thoralt/esp8266wordclock/ledfunctions.cpp

// ESP8266 Wordclock
// Copyright (C) 2016 Thoralt Franz, https://github.com/thoralt
//
//  This module implements functions to manage the WS2812B LEDs. Two buffers contain
//  color information with current state and fade target state and are updated by
//  either simple set operations or integrated screensavers (matrix, stars, heart).
//  Also contains part of the data and logic for the hourglass animation.
//
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
// You should have received a copy of the GNU General Public License
// along with this program.  If not, see <http://www.gnu.org/licenses/>.
#include "ledfunctions.h"

//---------------------------------------------------------------------------------------
#if 1 // variables
//---------------------------------------------------------------------------------------

//---------------------------------------------------------------------------------------
// global instance
//---------------------------------------------------------------------------------------
LEDFunctionsClass LED = LEDFunctionsClass();

uint8_t fireBuf[NUM_PIXELS];
uint8_t plasmaBuf[NUM_PIXELS];

//---------------------------------------------------------------------------------------
// variables in PROGMEM (mapping table, images)
//---------------------------------------------------------------------------------------
#include "hourglass_animation.h"

// This defines the LED output for different minutes
// param0 controls whether the hour has to be incremented for the given minutes
// param1 is the matching minimum minute count (inclusive)
// param2 is the matching maximum minute count (inclusive)
#if 1 // code folding minutes template
const std::vector<leds_template_t> LEDFunctionsClass::minutesTemplate =
{
	{0,  0,  4, {107, 108, 109}},                                  // UHR
	{0,  5,  9, {7, 8, 9, 10, 40, 41, 42, 43}},                    // F�NF NACH
	{0, 10, 14, {11, 12, 13, 14, 40, 41, 42, 43}},                 // ZEHN NACH
	{1, 15, 19, {26, 27, 28, 29, 30, 31, 32}},                     // VIERTEL
	{1, 20, 24, {11, 12, 13, 14, 18, 19, 20, 33, 34, 35, 36}},     // ZEHN VOR HALB
	{1, 25, 29, {7, 8, 9, 10, 18, 19, 20, 33, 34, 35, 36}},        // F�NF VOR HALB
	{1, 30, 34, {33, 34, 35, 36}},                                 // HALB
	{1, 35, 39, {7, 8, 9, 10, 40, 41, 42, 43, 33, 34, 35, 36}},    // F�NF NACH HALB
	{1, 35, 39, {7, 8, 9, 10, 40, 41, 42, 43, 33, 34, 35, 36}},    // F�NF NACH HALB
/*	{1, 35, 39, {11, 12, 13, 14, 18, 19, 20, 22, 23, 24, 25, 26, 27, 28, 29, 30, 31, 32 }}, // ZEHN VOR DREIVIERTEL */
	{1, 40, 44, {11, 12, 13, 14, 40, 41, 42, 43, 33, 34, 35, 36}}, // ZEHN NACH HALB
/*	{1, 40, 44, {7, 8, 9, 10, 18, 19, 20, 22, 23, 24, 25, 26, 27, 28, 29, 30, 31, 32 }}, // F�NF VOR DREIVIERTEL */
	{1, 45, 49, {22, 23, 24, 25, 26, 27, 28, 29, 30, 31, 32 }},    // DREIVIERTEL
	{1, 50, 54, {11, 12, 13, 14, 18, 19, 20}},                     // ZEHN VOR
	{1, 55, 59, {7, 8, 9, 10, 18, 19, 20}}                         // F�NF VOR
};
#endif

// This defines the LED output for different hours
// param0 deals with special cases:
//     = 0: matches hour in param1 and param2
//     = 1: matches hour in param1 and param2 whenever minute is < 5
//     = 2: matches hour in param1 and param2 whenever minute is >= 5
// param1: hour to match
// param2: alternative hour to match
#if 1 // code folding hours template
const std::vector<leds_template_t> LEDFunctionsClass::hoursTemplate =
{
	{0,  0, 12, {99, 100, 101, 102, 103}}, // ZW�LF
	{1,  1, 13, {44, 45, 46}},             // EIN
	{2,  1, 13, {44, 45, 46, 47}},         // EINS
	{0,  2, 14, {51, 52, 53, 54}},         // ZWEI
	{0,  3, 15, {55, 56, 57, 58}},         // DREI
	{0,  4, 16, {62, 63, 64, 65}},         // VIER
	{0,  5, 17, {66, 67, 68, 69}},         // F�NF
	{0,  6, 18, {72, 73, 74, 75, 76}},     // SECHS
	{0,  7, 19, {77, 78, 79, 80, 81, 82}}, // SIEBEN
	{0,  8, 20, {84, 85, 86, 87}},         // ACHT
	{0,  9, 21, {88, 89, 90, 91}},         // NEUN
	{0, 10, 22, {92, 93, 94, 95}},         // ZEHN
	{0, 11, 23, {96, 97, 98}},             // ELF
};
#endif

#if 1 // code folding mapping table
// this mapping table maps the linear memory buffer structure used throughout the
// project to the physical layout of the LEDs
const uint32_t PROGMEM LEDFunctionsClass::mapping[NUM_PIXELS] = {
	10,   9,   8,   7,   6,   5,   4,   3,   2,   1,   0,
	11,  12,  13,  14,  15,  16,  17,  18,  19,  20,  21,
	32,  31,  30,  29,  28,  27,  26,  25,  24,  23,  22,
	33,  34,  35,  36,  37,  38,  39,  40,  41,  42,  43,
	54,  53,  52,  51,  50,  49,  48,  47,  46,  45,  44,
	55,  56,  57,  58,  59,  60,  61,  62,  63,  64,  65,
	76,  75,  74,  73,  72,  71,  70,  69,  68,  67,  66,
	77,  78,  79,  80,  81,  82,  83,  84,  85,  86,  87,
	98,  97,  96,  95,  94,  93,  92,  91,  90,  89,  88,
	99, 100, 101, 102, 103, 104, 105, 106, 107, 108, 109,
	112, 111, 110, 113
};
#endif

#if 1 // code folding brightness adjust tables
const uint32_t PROGMEM LEDFunctionsClass::brightnessCurveSelect[NUM_PIXELS] = {
				0, 0, 0, 0, 0, 0, 0, 0, 0, 0, 0,
				0, 0, 0, 0, 0, 0, 0, 0, 0, 0, 0,
				0, 0, 0, 0, 0, 0, 0, 0, 0, 0, 0,
				0, 0, 0, 0, 0, 0, 0, 0, 0, 0, 0,
				0, 0, 0, 0, 0, 0, 0, 0, 0, 0, 0,
				0, 0, 0, 0, 0, 0, 0, 0, 0, 0, 0,
				0, 0, 0, 0, 0, 0, 0, 0, 0, 0, 0,
				0, 0, 0, 0, 0, 0, 0, 0, 0, 0, 0,
				0, 0, 0, 0, 0, 0, 0, 0, 0, 0, 0,
				0, 0, 0, 0, 0, 0, 0, 0, 0, 0, 0,
				0, 0, 0, 0
		//		0, 0, 0, 0, 0, 0, 0, 0, 0, 0, 0,
		//		0, 0, 0, 0, 0, 0, 0, 0, 0, 0, 0,
		//		0, 0, 0, 0, 0, 0, 0, 0, 0, 0, 0,
		//		0, 0, 0, 0, 0, 0, 0, 0, 0, 0, 0,
		//		0, 0, 0, 0, 0, 0, 0, 0, 0, 0, 0,
		//		0, 0, 0, 0, 0, 0, 0, 0, 0, 0, 0,
		//		0, 0, 0, 0, 0, 0, 0, 0, 0, 0, 0,
		//		0, 0, 0, 0, 0, 0, 0, 0, 0, 0, 0,
		//		0, 0, 0, 1, 0, 0, 0, 0, 0, 0, 0,
		//		0, 0, 0, 0, 0, 0, 0, 0, 0, 0, 0,
		//		0, 0, 0, 0
		//		0, 0, 0, 0, 0, 0, 1, 0, 0, 0, 0,
		//		1, 0, 0, 0, 0, 0, 0, 0, 0, 0, 0,
		//		0, 0, 0, 0, 0, 0, 0, 0, 0, 0, 0,
		//		0, 0, 0, 0, 0, 0, 0, 0, 0, 0, 0,
		//		0, 0, 0, 0, 0, 0, 0, 0, 0, 0, 0,
		//		0, 0, 0, 0, 0, 0, 0, 0, 0, 0, 0,
		//		0, 0, 0, 0, 0, 0, 0, 0, 0, 0, 0,
		//		0, 1, 1, 1, 1, 1, 1, 1, 1, 1, 1,
		//		1, 1, 1, 1, 1, 1, 1, 1, 1, 1, 0,
		//		0, 1, 1, 1, 1, 1, 1, 1, 1, 0, 1,
		//		0, 1, 0, 1
};

const uint32_t PROGMEM LEDFunctionsClass::brightnessCurvesR[256*NUM_BRIGHTNESS_CURVES] = {
		// LED type 1, 1:1 mapping (neutral)
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
		208, 209, 210, 211, 212, 213, 214, 215, 216, 217, 218, 219, 220,
		221, 222, 223, 224, 225, 226, 227, 228, 229, 230, 231, 232, 233,
		234, 235, 236, 237, 238, 239, 240, 241, 242, 243, 244, 245, 246,
		247, 248, 249, 250, 251, 252, 253, 254, 255,

		// LED type 2
		0, 0, 0, 0, 0, 0, 0, 0, 0, 0, 3, 3, 5, 5, 5, 5, 5, 5, 7, 7, 7, 7, 9,
		9, 9, 9, 9, 9, 11, 11, 11, 11, 13, 13, 13, 13, 15, 15, 15, 15, 17,
		17, 19, 19, 20, 20, 21, 21, 23, 23, 25, 25, 27, 27, 29, 29, 31, 31,
		33, 33, 35, 35, 37, 37, 39, 39, 41, 41, 42, 42, 43, 43, 45, 45, 47,
		47, 49, 49, 51, 51, 53, 53, 55, 55, 57, 57, 59, 59, 61, 61, 63, 63,
		64, 64, 66, 66, 68, 68, 72, 72, 72, 72, 74, 74, 76, 76, 78, 78, 80,
		80, 82, 82, 84, 84, 86, 86, 88, 88, 90, 90, 91, 91, 93, 93, 94, 94,
		96, 96, 98, 98, 100, 100, 102, 102, 104, 104, 106, 106, 108, 108,
		110, 110, 112, 112, 114, 114, 116, 116, 118, 118, 119, 119, 121, 121,
		123, 123, 124, 124, 127, 127, 129, 129, 131, 131, 133, 133, 135, 137,
		137, 139, 139, 141, 141, 143, 143, 145, 145, 147, 147, 149, 149, 151,
		151, 153, 153, 155, 155, 157, 157, 160, 160, 161, 161, 163, 163, 166,
		166, 168, 168, 170, 170, 171, 171, 174, 174, 176, 176, 178, 178, 180,
		180, 183, 183, 184, 184, 187, 187, 188, 188, 191, 191, 194, 194, 196,
		196, 198, 198, 200, 200, 202, 202, 204, 204, 206, 206, 209, 209, 210,
		210, 212, 212, 215, 215, 217, 217, 219, 219, 222, 222, 224, 224, 226,
		226, 228, 228, 230
};

#endif

#endif

//---------------------------------------------------------------------------------------
#if 1 // getters, setters, data flow
//---------------------------------------------------------------------------------------

//---------------------------------------------------------------------------------------
// ~LEDFunctionsClass
//
// Destructor
//
// -> --
// <- --
//---------------------------------------------------------------------------------------
LEDFunctionsClass::~LEDFunctionsClass()
{
//	for(MatrixObject* m : this->matrix_objects) delete m;
}

//---------------------------------------------------------------------------------------
// LEDFunctionsClass
//
// Constructor, initializes data structures
//
// -> --
// <- --
//---------------------------------------------------------------------------------------
LEDFunctionsClass::LEDFunctionsClass()
{
	// initialize matrix objects with random coordinates
	for (int i = 0; i < NUM_MATRIX_OBJECTS; i++)
	{
		this->matrix.push_back(MatrixObject());
	}

	// initialize star objects with default coordinates
	for (int i = 0; i < NUM_STARS; i++) this->stars.push_back(StarObject());

	// set random coordinates with minimum distance to other star objects
	for (StarObject& s : this->stars) s.randomize(this->stars);
}

//---------------------------------------------------------------------------------------
// begin
//
// Initializes the LED driver
//
// -> pin: hardware pin to use for WS2812B data output
// <- --
//---------------------------------------------------------------------------------------
void LEDFunctionsClass::begin(int pin)
{
	this->pixels = new Adafruit_NeoPixel(NUM_PIXELS, pin, NEO_GRB + NEO_KHZ800);
	this->pixels->begin();
}

//---------------------------------------------------------------------------------------
// process
//
// Drives internal data flow, should be called repeatedly from main loop()
//
// -> --
// <- --
//---------------------------------------------------------------------------------------
void LEDFunctionsClass::process()
{
	if(Config.debugMode) return;

	// check time values against boundaries
	if(this->h > 23 || this->h < 0) this->h = 0;
	if(this->m > 59 || this->m < 0) this->m = 0;
	if(this->s > 59 || this->s < 0) this->s = 0;
	if(this->ms > 999 || this->ms < 0) this->ms = 0;

	// load palette colors from configuration
	palette_entry palette[] = {
		{Config.bg.r, Config.bg.g, Config.bg.b},
		{Config.fg.r, Config.fg.g, Config.fg.b},
		{Config.s.r,  Config.s.g,  Config.s.b}};
	uint8_t buf[NUM_PIXELS];

	switch(this->mode)
	{
	case DisplayMode::wifiManager:
		this->renderWifiManager();
		break;
	case DisplayMode::yellowHourglass:
		this->renderHourglass(Config.hourglassState, false);
		break;
	case DisplayMode::greenHourglass:
		this->renderHourglass(Config.hourglassState, true);
		break;
	case DisplayMode::update:
		this->renderUpdate();
		break;
	case DisplayMode::updateComplete:
		this->renderUpdateComplete();
		break;
	case DisplayMode::updateError:
		this->renderUpdateError();
		break;
	case DisplayMode::red:
		this->renderRed();
		break;
	case DisplayMode::green:
		this->renderGreen();
		break;
	case DisplayMode::blue:
		this->renderBlue();
		break;
	case DisplayMode::flyingLettersVerticalUp:
	case DisplayMode::flyingLettersVerticalDown:
		this->renderFlyingLetters();
		break;
	case DisplayMode::explode:
		this->renderExplosion();
		break;
	case DisplayMode::matrix:
		this->renderMatrix();
		break;
	case DisplayMode::heart:
		this->renderHeart();
		break;
	case DisplayMode::stars:
		this->renderStars();
		break;
	case DisplayMode::fire:
		this->renderFire();
		break;
	case DisplayMode::plasma:
		this->renderPlasma();
		break;
	case DisplayMode::fade:
		this->renderTime(buf, this->h, this->m, this->s, this->ms);
		this->set(buf, palette, false);
		this->fade();
		break;

	case DisplayMode::random: // TODO: Implement random display mode
	case DisplayMode::plain:
	default:
		this->renderTime(buf, this->h, this->m, this->s, this->ms);
		this->set(buf, palette, true);
		break;
	}


	// transfer this->currentValues to LEDs
	this->show();
}

//---------------------------------------------------------------------------------------
// setBrightness
//
// Sets the brightness for the WS2812 values. Will be multiplied with each color
// component when sending data to WS2812.
//
// -> brightness: [0...256]
// <- --
//---------------------------------------------------------------------------------------
void LEDFunctionsClass::setBrightness(int brightness)
{
	this->brightness = brightness;
}

//---------------------------------------------------------------------------------------
// setTime
//
// Sets the time which will be used to drive the LED matrix. The internal time is _not_
// updated, this function must be called repeatedly if the time changes.
//
// -> h, m, s, ms: Time in hours, minutes, seconds, milliseconds
// <- --
//---------------------------------------------------------------------------------------
void LEDFunctionsClass::setTime(int h, int m, int s, int ms)
{
	this->h = h;
	this->m = m;
	this->s = s;
	this->ms = ms;
}

//---------------------------------------------------------------------------------------
// setMode
//
// Sets the display mode to one of the members of the DisplayMode enum and thus changes
// what will be shown on the display during the next calls of LEDFunctionsClass.process()
//
// -> newMode: mode to be set
// <- --
//---------------------------------------------------------------------------------------
void LEDFunctionsClass::setMode(DisplayMode newMode)
{
	uint8_t buf[NUM_PIXELS];
	DisplayMode previousMode = this->mode;
	this->mode = newMode;

	// if we changed to an animated letters mode, then start animation
	// even if the current time did not yet change
	if(newMode != previousMode &&
			(newMode == DisplayMode::flyingLettersVerticalUp ||
			newMode == DisplayMode::flyingLettersVerticalDown))
	{
		this->renderTime(buf, this->h, this->m, this->s, this->ms);
		this->prepareFlyingLetters(buf);
	}

	// if we changed to exploding letters mode, then start animation
	// even if the current time did not yet change
	if(newMode != previousMode && newMode == DisplayMode::explode)
	{
		this->renderTime(buf, this->h, this->m, this->s, this->ms);
		this->prepareExplosion(buf);
	}

	this->process();
}

//---------------------------------------------------------------------------------------
// set
//
// Sets the internal LED buffer to new values based on an indexed source buffer and an
// associated palette. Does not display colors immediately, fades to new colors instead.
//
// Attention: If buf is PROGMEM, make sure it is aligned at 32 bit and its size is
// a multiple of 4 bytes!
//
// -> buf: indexed source buffer
//	palette: color definition for source buffer
// <- --
//---------------------------------------------------------------------------------------
void LEDFunctionsClass::set(const uint8_t *buf, palette_entry palette[])
{
	this->set(buf, palette, false);
}

//---------------------------------------------------------------------------------------
// set
//
// Sets the internal LED buffer to new values based on an indexed source buffer and an
// associated palette.
//
// Attention: If buf is PROGMEM, make sure it is aligned at 32 bit and its size is
// a multiple of 4 bytes!
//
// -> buf: indexed source buffer
//	  palette: color definition for source buffer
//	  immediately: if true, display buffer immediately; fade to new colors if false
// <- --
//---------------------------------------------------------------------------------------
void LEDFunctionsClass::set(const uint8_t *buf, palette_entry palette[],
		bool immediately)
{
	this->setBuffer(this->targetValues, buf, palette);

	if (immediately)
	{
		this->setBuffer(this->currentValues, buf, palette);
	}
}

//---------------------------------------------------------------------------------------
// setBuffer
//
// Fills a buffer (e. g. this->targetValues) with color data based on indexed source
// pixels and a palette. Pays attention to 32 bit boundaries, so use with PROGMEM is
// safe.
//
// -> target: color buffer, e. g. this->targetValues or this->currentValues
//    source: buffer with color indexes
//	  palette: colors for indexed source buffer
// <- --
//---------------------------------------------------------------------------------------
void LEDFunctionsClass::setBuffer(uint8_t *target, const uint8_t *source,
		palette_entry palette[])
{
	uint32_t mapping, palette_index, curveOffset;

	// cast source to 32 bit pointer to ensure 32 bit aligned access
	uint32_t *buf = (uint32_t*) source;
	// this holds the current 4 bytes
	uint32_t currentDWord;
	// this is a pointer to the current 4 bytes for access as single bytes
	uint8_t *currentBytes = (uint8_t*) &currentDWord;
	// this counts bytes from 0...3
	uint32_t byteCounter = 0;
	for (int i = 0; i < NUM_PIXELS; i++)
	{
		// get next 4 bytes
		if (byteCounter == 0) currentDWord = buf[i >> 2];

		palette_index = currentBytes[byteCounter];
		mapping = LEDFunctionsClass::mapping[i] * 3;
		curveOffset = LEDFunctionsClass::brightnessCurveSelect[i] << 8;

		// select color value using palette and brightness correction curves
		target[mapping + 0] = brightnessCurvesR[curveOffset + palette[palette_index].r];
		target[mapping + 1] = brightnessCurvesG[curveOffset + palette[palette_index].g];
		target[mapping + 2] = brightnessCurvesB[curveOffset + palette[palette_index].b];

		byteCounter = (byteCounter + 1) & 0x03;
	}
}

//---------------------------------------------------------------------------------------
// fade
//
// Fade one step of the color values from this->currentValues[i] to 
// this->targetValues[i]. Uses non-linear fade speed depending on distance to target
// value.
//
// -> --
// <- --
//---------------------------------------------------------------------------------------
void LEDFunctionsClass::fade()
{
	static int prescaler = 0;
	if(++prescaler<2) return;
	prescaler = 0;

	int delta;
	for (int i = 0; i < NUM_PIXELS * 3; i++)
	{
		delta = this->targetValues[i] - this->currentValues[i];
		if (delta > 64) this->currentValues[i] += 8;
		else if (delta > 16) this->currentValues[i] += 4;
		else if (delta > 0) this->currentValues[i]++;
		else if (delta < -64) this->currentValues[i] -= 8;
		else if (delta < -16) this->currentValues[i] -= 4;
		else if (delta < 0) this->currentValues[i]--;
	}
}

//---------------------------------------------------------------------------------------
// show
//
// Internal method, copies this->currentValues to WS2812 object while applying brightness
//
// -> --
// <- --
//---------------------------------------------------------------------------------------
void LEDFunctionsClass::show()
{
	uint8_t *data = this->currentValues;
	int ofs = 0;

	// copy current color values to LED object and display it
	for (int i = 0; i < NUM_PIXELS; i++)
	{
		this->pixels->setPixelColor(i,
				pixels->Color(((int) data[ofs + 0] * this->brightness) >> 8,
						      ((int) data[ofs + 1] * this->brightness) >> 8,
						      ((int) data[ofs + 2] * this->brightness) >> 8));
		ofs += 3;
	}
	this->pixels->show();
}

//---------------------------------------------------------------------------------------
// getOffset
//
// Calculates the offset of a given RGB triplet inside the LED buffer.
// Does range checking for x and y, uses the internal mapping table.
//
// -> x: x coordinate
//    y: y coordinate
// <- offset for given coordinates
//---------------------------------------------------------------------------------------
int LEDFunctionsClass::getOffset(int x, int y)
{
	if (x>=0 && y>=0 && x<LEDFunctionsClass::width && y<LEDFunctionsClass::height)
	{
		return LEDFunctionsClass::mapping[x + y*LEDFunctionsClass::width] * 3;
	}
	else
	{
		return 0;
	}
}

//---------------------------------------------------------------------------------------
// fillBackground
//
// Initializes the buffer with either background (=0) or seconds progress (=2),
// part of the background will be illuminated with color 2 depending on current
// seconds/milliseconds value, whole screen is backlit when seconds = 59
//
// -> seconds, milliseconds: Time value which the fill process will base on
//    buf: destination buffer
// <- --
//---------------------------------------------------------------------------------------
void LEDFunctionsClass::fillBackground(int seconds, int milliseconds, uint8_t *buf)
{
	int pos = (((seconds * 1000 + milliseconds) * 110) / 60000) + 1;
	for (int i = 0; i < NUM_PIXELS; i++) buf[i] = (i < pos) ? 2 : 0;
}

#endif

//---------------------------------------------------------------------------------------
#if 1 // rendering methods
//---------------------------------------------------------------------------------------

//---------------------------------------------------------------------------------------
// renderTime
//
// Loads internal buffers with the current time representation
//
// -> target: If NULL, a local buffer is used and time is actually being displayed
//            if not null, time is not being displayed, but the given buffer is being
//            filled with palette indexes representing the time
// <- --
//---------------------------------------------------------------------------------------
void LEDFunctionsClass::renderTime(uint8_t *target, int h, int m, int s, int ms)
{
	this->fillBackground(s, ms, target);

	// set static LEDs
	target[0] = 1; // E
	target[1] = 1; // S

	target[3] = 1; // I
	target[4] = 1; // S
	target[5] = 1; // T

	// minutes 1...4 for the corners
	for(int i=0; i<=((m%5)-1); i++) target[10 * 11 + i] = 1;

	// iterate over minutes_template
	int adjust_hour = 0;
	for(leds_template_t t : LEDFunctionsClass::minutesTemplate)
	{
		// test if this template matches the current minute
		if(m >= t.param1 && m <= t.param2)
		{
			// set all LEDs defined in this template
			for(int i : t.LEDs) target[i] = 1;
			adjust_hour = t.param0;
			break;
		}
	}

	// adjust hour display if necessary (e. g. 09:45 = quarter to *TEN* instead of NINE)
	h += adjust_hour;
	if(h > 23)	h -= 24;

	// iterate over hours template
	for(leds_template_t t : LEDFunctionsClass::hoursTemplate)
	{
		// test if this template matches the current hour
		if((t.param1 == h || t.param2 == h) &&
		   ((t.param0 == 1 && m < 5)  || // special case full hour
			(t.param0 == 2 && m >= 5) || // special case hour + minutes
			(t.param0 == 0)))            // normal case
		{
			// set all LEDs defined in this template
			for(int i : t.LEDs) target[i] = 1;
			break;
		}
	}

	// DEBUG
	static int last_minutes = -1;
	if(last_minutes != this->m)
	{
		last_minutes = this->m;
		Serial.printf("h=%i, m=%i, s=%i\r\n", this->h, this->m, this->s);
		for(int y=0; y<10; y++)
		{
			for(int x=0; x<11; x++)
			{
				Serial.print(target[y*11+x]);
				Serial.print(' ');
			}
			Serial.println(' ');
		}
	}
}

//---------------------------------------------------------------------------------------
// renderHourglass
//
// Immediately displays an animation step of the hourglass animation.
// ATTENTION: Animation frames must start at 32 bit boundary each!
//
// -> animationStep: Number of current frame [0...HOURGLASS_ANIMATION_FRAMES]
//    green: Flag to switch the palette color 3 to green instead of yellow (used in the
//           second half of the hourglass animation to indicate the short wait-for-OTA
//           window)
// <- --
//---------------------------------------------------------------------------------------
void LEDFunctionsClass::renderHourglass(uint8_t animationStep, bool green)
{
	// colors in palette: black, white, yellow
	palette_entry p[] = {{0, 0, 0}, {255, 255, 255}, {255, 255, 0}, {255, 255, 0}};

	// delete red component in palette entry 3 to make this color green
	if(green) p[3].r = 0;

	if (animationStep >= HOURGLASS_ANIMATION_FRAMES) animationStep = 0;
	this->set(hourglass_animation[animationStep], p, true);
}

//---------------------------------------------------------------------------------------
// renderMatrix
//
// Renders one frame of the matrix animation and displays it immediately
//
// -> --
// <- --
//---------------------------------------------------------------------------------------
void LEDFunctionsClass::renderMatrix()
{
	// clear buffer
	memset(this->currentValues, 0, sizeof(this->currentValues));

	// sort by y coordinate for correct overlapping
	std::sort(matrix.begin(), matrix.end());

	// iterate over all matrix objects, move and render them
	for (MatrixObject &m : this->matrix) m.render(this->currentValues);
}

const palette_entry LEDFunctionsClass::firePalette[256] = {
	{0, 0, 0}, {4, 0, 0}, {8, 0, 0}, {12, 0, 0}, {16, 0, 0}, {20, 0, 0}, {24, 0, 0}, {28, 0, 0},
	{32, 0, 0}, {36, 0, 0}, {40, 0, 0}, {44, 0, 0}, {48, 0, 0}, {52, 0, 0}, {56, 0, 0}, {60, 0, 0},
	{64, 0, 0}, {68, 0, 0}, {72, 0, 0}, {76, 0, 0}, {80, 0, 0}, {85, 0, 0}, {89, 0, 0}, {93, 0, 0},
	{97, 0, 0}, {101, 0, 0}, {105, 0, 0}, {109, 0, 0}, {113, 0, 0}, {117, 0, 0}, {121, 0, 0}, {125, 0, 0},
	{129, 0, 0}, {133, 0, 0}, {137, 0, 0}, {141, 0, 0}, {145, 0, 0}, {149, 0, 0}, {153, 0, 0}, {157, 0, 0},
	{161, 0, 0}, {165, 0, 0}, {170, 0, 0}, {174, 0, 0}, {178, 0, 0}, {182, 0, 0}, {186, 0, 0}, {190, 0, 0},
	{194, 0, 0}, {198, 0, 0}, {202, 0, 0}, {206, 0, 0}, {210, 0, 0}, {214, 0, 0}, {218, 0, 0}, {222, 0, 0},
	{226, 0, 0}, {230, 0, 0}, {234, 0, 0}, {238, 0, 0}, {242, 0, 0}, {246, 0, 0}, {250, 0, 0}, {255, 0, 0},
	{255, 0, 0}, {255, 8, 0}, {255, 16, 0}, {255, 24, 0}, {255, 32, 0}, {255, 41, 0}, {255, 49, 0}, {255, 57, 0},
	{255, 65, 0}, {255, 74, 0}, {255, 82, 0}, {255, 90, 0}, {255, 98, 0}, {255, 106, 0}, {255, 115, 0}, {255, 123, 0},
	{255, 131, 0}, {255, 139, 0}, {255, 148, 0}, {255, 156, 0}, {255, 164, 0}, {255, 172, 0}, {255, 180, 0}, {255, 189, 0},
	{255, 197, 0}, {255, 205, 0}, {255, 213, 0}, {255, 222, 0}, {255, 230, 0}, {255, 238, 0}, {255, 246, 0}, {255, 255, 0},
	{255, 255, 0}, {255, 255, 1}, {255, 255, 3}, {255, 255, 4}, {255, 255, 6}, {255, 255, 8}, {255, 255, 9}, {255, 255, 11},
	{255, 255, 12}, {255, 255, 14}, {255, 255, 16}, {255, 255, 17}, {255, 255, 19}, {255, 255, 20}, {255, 255, 22}, {255, 255, 24},
	{255, 255, 25}, {255, 255, 27}, {255, 255, 28}, {255, 255, 30}, {255, 255, 32}, {255, 255, 33}, {255, 255, 35}, {255, 255, 36},
	{255, 255, 38}, {255, 255, 40}, {255, 255, 41}, {255, 255, 43}, {255, 255, 44}, {255, 255, 46}, {255, 255, 48}, {255, 255, 49},
	{255, 255, 51}, {255, 255, 52}, {255, 255, 54}, {255, 255, 56}, {255, 255, 57}, {255, 255, 59}, {255, 255, 60}, {255, 255, 62},
	{255, 255, 64}, {255, 255, 65}, {255, 255, 67}, {255, 255, 68}, {255, 255, 70}, {255, 255, 72}, {255, 255, 73}, {255, 255, 75},
	{255, 255, 76}, {255, 255, 78}, {255, 255, 80}, {255, 255, 81}, {255, 255, 83}, {255, 255, 85}, {255, 255, 86}, {255, 255, 88},
	{255, 255, 89}, {255, 255, 91}, {255, 255, 93}, {255, 255, 94}, {255, 255, 96}, {255, 255, 97}, {255, 255, 99}, {255, 255, 101},
	{255, 255, 102}, {255, 255, 104}, {255, 255, 105}, {255, 255, 107}, {255, 255, 109}, {255, 255, 110}, {255, 255, 112}, {255, 255, 113},
	{255, 255, 115}, {255, 255, 117}, {255, 255, 118}, {255, 255, 120}, {255, 255, 121}, {255, 255, 123}, {255, 255, 125}, {255, 255, 126},
	{255, 255, 128}, {255, 255, 129}, {255, 255, 131}, {255, 255, 133}, {255, 255, 134}, {255, 255, 136}, {255, 255, 137}, {255, 255, 139},
	{255, 255, 141}, {255, 255, 142}, {255, 255, 144}, {255, 255, 145}, {255, 255, 147}, {255, 255, 149}, {255, 255, 150}, {255, 255, 152},
	{255, 255, 153}, {255, 255, 155}, {255, 255, 157}, {255, 255, 158}, {255, 255, 160}, {255, 255, 161}, {255, 255, 163}, {255, 255, 165},
	{255, 255, 166}, {255, 255, 168}, {255, 255, 170}, {255, 255, 171}, {255, 255, 173}, {255, 255, 174}, {255, 255, 176}, {255, 255, 178},
	{255, 255, 179}, {255, 255, 181}, {255, 255, 182}, {255, 255, 184}, {255, 255, 186}, {255, 255, 187}, {255, 255, 189}, {255, 255, 190},
	{255, 255, 192}, {255, 255, 194}, {255, 255, 195}, {255, 255, 197}, {255, 255, 198}, {255, 255, 200}, {255, 255, 202}, {255, 255, 203},
	{255, 255, 205}, {255, 255, 206}, {255, 255, 208}, {255, 255, 210}, {255, 255, 211}, {255, 255, 213}, {255, 255, 214}, {255, 255, 216},
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
	{255, 0, 48}, {255, 0, 42}, {255, 0, 36}, {255, 0, 30}, {255, 0, 24}, {255, 0, 18}, {255, 0, 12}, {255, 0, 6}
};


double _time = 0;
void LEDFunctionsClass::renderPlasma()
{
    int color;
    double cx, cy, xx, yy;

    _time += 0.05;

    for (int y=0; y<LEDFunctionsClass::height; y++)
    {
        yy = (double)y / (double)LEDFunctionsClass::height / 3.0;
        for (int x=0; x<LEDFunctionsClass::width; x++)
        {
            xx = (double)x / (double)LEDFunctionsClass::width / 3.0;
            cx = xx + 0.5 * sin(_time / 5.0);
            cy = (double)y/(double)LEDFunctionsClass::height / 3.0 + 0.5 * sin(_time / 3.0);
            color = (
            	sin(
                    sqrt(100 * (cx*cx + cy*cy) + 1 + _time) +
                    6.0 * (xx * sin(_time/2) + yy * cos(_time/3) + _time / 4.0)
                ) + 1.0
			) * 128.0;
            plasmaBuf[x + y * LEDFunctionsClass::width] = color;
        }
    }
    this->set(plasmaBuf, (palette_entry*)plasmaPalette, true);
}

void LEDFunctionsClass::renderFire()
{
    int f;

    // iterate over bottom row, create fire seed
    for (int i = 0; i < LEDFunctionsClass::width; i++)
    {
        // only set hot spot with probability of 1/4
        f = (random(4) == 0) ? random(256) : 0;

        // update one pixel in bottom row
        fireBuf[i + (LEDFunctionsClass::height - 1) * LEDFunctionsClass::width] = f;
    }

    int y1, y2, l, r;
    for (int y = 0; y < LEDFunctionsClass::height - 1; y++)
    {
        y1 = y + 1; if (y1 >= LEDFunctionsClass::height) y1 = LEDFunctionsClass::height - 1;
        y2 = y + 2; if (y2 >= LEDFunctionsClass::height) y2 = LEDFunctionsClass::height - 1;
        for (int x = 0; x < LEDFunctionsClass::width; x++)
        {
            l = x - 1; if (l < 0) l = 0;
            r = x + 1; if (r >= LEDFunctionsClass::width) r = LEDFunctionsClass::width - 1;
            fireBuf[x + y * LEDFunctionsClass::width] =
                ((fireBuf[y1 * LEDFunctionsClass::width + l]
                + fireBuf[y1 * LEDFunctionsClass::width + x]
                + fireBuf[y1 * LEDFunctionsClass::width + r]
                + fireBuf[y2 * LEDFunctionsClass::width + x])
                * 32) / 129;
        }
    }
    this->set(fireBuf, (palette_entry*)firePalette, true);
	delay(100);
}

//---------------------------------------------------------------------------------------
// renderStars
//
// Renders one frame of the stars animation and displays it immediately
//
// -> --
// <- --
//---------------------------------------------------------------------------------------
void LEDFunctionsClass::renderStars()
{
	// clear buffer
	memset(this->currentValues, 0, sizeof(this->currentValues));

	for(StarObject &s : this->stars) s.render(this->currentValues, this->stars);
}

//---------------------------------------------------------------------------------------
// renderHeart
//
// Renders one frame of the heart animation and displays it immediately
//
// -> --
// <- --
//---------------------------------------------------------------------------------------
void LEDFunctionsClass::renderHeart()
{
	palette_entry palette[2];
	uint8_t heart[] = {
		0, 1, 1, 1, 0, 0, 0, 1, 1, 1, 0,
		1, 1, 1, 1, 1, 0, 1, 1, 1, 1, 1,
		1, 1, 1, 1, 1, 1, 1, 1, 1, 1, 1,
		1, 1, 1, 1, 1, 1, 1, 1, 1, 1, 1,
		0, 1, 1, 1, 1, 1, 1, 1, 1, 1, 0,
		0, 0, 1, 1, 1, 1, 1, 1, 1, 0, 0,
		0, 0, 0, 1, 1, 1, 1, 1, 0, 0, 0,
		0, 0, 0, 0, 1, 1, 1, 0, 0, 0, 0,
		0, 0, 0, 0, 0, 1, 0, 0, 0, 0, 0,
		0, 0, 0, 0, 0, 0, 0, 0, 0, 0, 0,
		1, 1, 1, 1
	};
	palette[0] = {0, 0, 0};
	palette[1] = {(uint8_t)this->heartBrightness, 0, 0};
	this->set(heart, palette, true);

	switch (this->heartState)
	{
	case 0:
		if (this->heartBrightness >= 255) this->heartState = 1;
		else this->heartBrightness += 32;
		break;

	case 1:
		if (this->heartBrightness < 128) this->heartState = 2;
		else this->heartBrightness -= 32;
		break;

	case 2:
		if (this->heartBrightness >= 255) this->heartState = 3;
		else this->heartBrightness += 32;
		break;

	case 3:
	default:
		if (this->heartBrightness <= 0) this->heartState = 0;
		else this->heartBrightness -= 4;
		break;
	}

	if (this->heartBrightness > 255) this->heartBrightness = 255;
	if (this->heartBrightness < 0) this->heartBrightness = 0;
}

//---------------------------------------------------------------------------------------
// prepareExplosion
//
// Prepare particles based on current screen state
//
//
// -> source: buffer to read the currently active LEDs from
// <- --
//---------------------------------------------------------------------------------------
void LEDFunctionsClass::prepareExplosion(uint8_t *source)
{
#define PARTICLE_COUNT 16
#define PARTICLE_SPEED 0.15f

	float vx, vy, angle;
	int ofs = 0;
	Particle *p;
	int delay;

	// compute angle increment
	float angle_increment = 2.0f * 3.141592654f / (float)(PARTICLE_COUNT);

	// iterate over every position in the screen buffer
	for(int y=0; y<LEDFunctionsClass::height; y++)
	{
		for(int x=0; x<LEDFunctionsClass::width; x++)
		{
			// create entry in particles vector if current pixel is foreground
			if(source[ofs++] == 1)
			{
				// add a random delay of zero to approx. 3 seconds to each
				// explosion
				delay = random(300);

				// start with angle of zero radians, assign velocity vector
				// placed on a circle to each particle
				angle = 0;
				for(int i=0; i<PARTICLE_COUNT; i++)
				{
					// calculate particle speed vector based on angle and
					// absolute speed value
					vx = PARTICLE_SPEED * sin(angle);
					vy = PARTICLE_SPEED * cos(angle);

					// create new particle and add it to particles list
					p = new Particle(x, y, vx, vy, delay);
					this->particles.push_back(p);
					angle += angle_increment;
				}
			}
		}
	}
}

//---------------------------------------------------------------------------------------
// renderExplosion
//
// Renders the exploding letters animation
//
// -> --
// <- --
//---------------------------------------------------------------------------------------
void LEDFunctionsClass::renderExplosion()
{
	std::vector<Particle*> particlesToKeep;
	uint8_t buf[NUM_PIXELS];

	// load palette colors from configuration
	palette_entry palette[] = {
		{Config.bg.r, Config.bg.g, Config.bg.b},
		{Config.fg.r, Config.fg.g, Config.fg.b},
		{Config.s.r,  Config.s.g,  Config.s.b}};

	// check if the displayed time has changed
	if((this->m/5 != this->lastM/5) || (this->h != this->lastH))
	{
		// prepare new animation with old time
		this->renderTime(buf, this->lastH, this->lastM, 0, 0);
		this->prepareExplosion(buf);
	}

	this->lastM = this->m;
	this->lastH = this->h;

	// create empty buffer filled with seconds color
	this->fillBackground(this->s, this->ms, buf);

	// minutes 1...4 for the corners
	for(int i=0; i<=((this->m%5)-1); i++) buf[10 * 11 + i] = 1;

	// Do we have something to explode?
	if(this->particles.size() > 0)
	{
		// transfer background created by fillBackground to target buffer
		this->set(buf, palette, true);

		// iterate over all particles
		for(Particle *p : this->particles)
		{
			// move and render current particle
			p->render(this->currentValues, palette);

			// if particle is still active, keep it; kill it otherwise
			if(p->alive) particlesToKeep.push_back(p); else delete p;
		}

		// only keep active particles, discard the rest
		// -> use particlesToKeep as new list
		this->particles.swap(particlesToKeep);
	}
	else
	{
		// present the current time in boring mode with simple fading
		this->renderTime(buf, this->h, this->m, this->s, this->ms);
		this->set(buf, palette, false);
		this->fade();
	}
}

//---------------------------------------------------------------------------------------
// prepareFlyingLetters
//
// Sets the current buffer as target state for flying letters, initializes current
// positions of the letters below the visible area with some random jitter
//
// -> source: buffer to read the currently active LEDs from
// <- --
//---------------------------------------------------------------------------------------
void LEDFunctionsClass::prepareFlyingLetters(uint8_t *source)
{
	// transfer the previous flying letters in the leaving letters vector to prepare for
	// outgoing animation
	this->leavingLetters.clear();
	for(xy_t &p : this->arrivingLetters)
	{
		// delay every letter depending on its position
		// and set new target coordinate
		if(this->mode == DisplayMode::flyingLettersVerticalUp)
		{
			p.delay = p.y * 2 + p.x + 1 + random(5);
			p.yTarget = -1;
		}
		else
		{
			p.delay = (LEDFunctionsClass::height - p.y - 1) * 2 + p.x + 1 + random(5);
			p.yTarget = LEDFunctionsClass::height;
		}
		this->leavingLetters.push_back(p);
	}

	// initialize arriving letters from scratch
	this->arrivingLetters.clear();
	int ofs = 0;

	// iterate over every position in the screen buffer
	for(int y=0; y<LEDFunctionsClass::height; y++)
	{
		for(int x=0; x<LEDFunctionsClass::width; x++)
		{
			// create entry in arrivingLetters vector if current pixel is foreground
			if(source[ofs++] == 1)
			{
				if(this->mode == DisplayMode::flyingLettersVerticalUp)
				{
					xy_t p = {x, y, x, LEDFunctionsClass::height,
							y * 2 + x + 1 + random(5), 200, 0};
					this->arrivingLetters.push_back(p);
				}
				else
				{
					xy_t p = {x, y, x, -1,
							(LEDFunctionsClass::height - y - 1) * 2 + x + 1 + random(5),
							200, 0};
					this->arrivingLetters.push_back(p);
				}
			}
		}
	}

	// DEBUG
	Serial.printf("h=%i, m=%i, s=%i, lastH=%i, lastM=%i\r\n", this->h, this->m, this->s, this->lastH, this->lastM);
	Serial.println("leavingLetters:");
	for(xy_t &p : this->leavingLetters)
	{
		Serial.printf("  counter=%i, delay=%i, speed=%i, x=%i, y=%i, xTarget=%i, yTarget=%i\r\n",
				p.counter, p.delay, p.speed, p.x, p.y, p.xTarget, p.yTarget);
	}
	Serial.println("arrivingLetters:");
	for(xy_t &p : this->arrivingLetters)
	{
		Serial.printf("  counter=%i, delay=%i, speed=%i, x=%i, y=%i, xTarget=%i, yTarget=%i\r\n",
				p.counter, p.delay, p.speed, p.x, p.y, p.xTarget, p.yTarget);
	}
}

//---------------------------------------------------------------------------------------
// renderFlyingLetters
//
// Takes the current arrivingLetters and leavingLetters to render the flying letters
// animation
//
// -> --
// <- --
//---------------------------------------------------------------------------------------
void LEDFunctionsClass::renderFlyingLetters()
{
	uint8_t buf[NUM_PIXELS];

	// load palette colors from configuration
	palette_entry palette[] = {
		{Config.bg.r, Config.bg.g, Config.bg.b},
		{Config.fg.r, Config.fg.g, Config.fg.b},
		{Config.s.r,  Config.s.g,  Config.s.b}};

	// check if the displayed time has changed
	if((this->m/5 != this->lastM/5) || (this->h != this->lastH))
	{
		// prepare new animation
		this->renderTime(buf, this->h, this->m, this->s, this->ms);
		this->prepareFlyingLetters(buf);
	}

	this->lastM = this->m;
	this->lastH = this->h;


	// create empty buffer filled with seconds color
	this->fillBackground(this->s, this->ms, buf);

	// minutes 1...4 for the corners
	for(int i=0; i<=((this->m%5)-1); i++) buf[10 * 11 + i] = 1;

	// leaving letters animation has priority
	if(this->leavingLetters.size() > 0)
	{
		// count actually moved letters to detect end of animation
		int movedLetters = 0;

		// iterate over all leavingLetters
		for(xy_t &p : this->leavingLetters)
		{
			// draw letter only if inside visible area
			if(p.x>=0 && p.y>=0 && p.x<LEDFunctionsClass::width
					&& p.y<LEDFunctionsClass::height)
				buf[p.x + p.y * LEDFunctionsClass::width] = 1;

			// continue with next letter if the current letter already
			// reached its target position
			if(p.y == p.yTarget && p.x == p.xTarget) continue;
			p.counter += p.speed;
			movedLetters++;
			if(p.counter >= 1000)
			{
				p.counter -= 1000;
				if(p.delay>0)
				{
					// do not move if animation of current letter is delayed
					p.delay--;
				}
				else
				{
					if(p.y > p.yTarget) p.y--; else p.y++;
				}
			}
		}
		if(movedLetters == 0) this->leavingLetters.clear();
	}
	else
	{
		// iterate over all arrivingLetters
		for(xy_t &p : this->arrivingLetters)
		{
			// draw letter only if inside visible area
			if(p.x>=0 && p.y>=0 && p.x<LEDFunctionsClass::width
					&& p.y<LEDFunctionsClass::height)
				buf[p.x + p.y * LEDFunctionsClass::width] = 1;

			// continue with next letter if the current letter already
			// reached its target position
			if(p.y == p.yTarget && p.x == p.xTarget) continue;
			p.counter += p.speed;
			if(p.counter >= 1000)
			{
				p.counter -= 1000;
				if(p.delay>0)
				{
					// do not move if animation of current letter is delayed
					p.delay--;
				}
				else
				{
					if(p.y > p.yTarget) p.y--; else p.y++;
				}
			}
		}
	}

	// present the current content immediately without fading
	this->set(buf, palette, true);
}

//---------------------------------------------------------------------------------------
// renderRed
//
// Renders a complete red frame for testing purposes.
//
// -> --
// <- --
//---------------------------------------------------------------------------------------
void LEDFunctionsClass::renderRed()
{
	palette_entry palette[2];
	uint8_t heart[] = {
		1, 1, 1, 1, 1, 1, 1, 1, 1, 1, 1,
		1, 1, 1, 1, 1, 1, 1, 1, 1, 1, 1,
		1, 1, 1, 1, 1, 1, 1, 1, 1, 1, 1,
		1, 1, 1, 1, 1, 1, 1, 1, 1, 1, 1,
		1, 1, 1, 1, 1, 1, 1, 1, 1, 1, 1,
		1, 1, 1, 1, 1, 1, 1, 1, 1, 1, 1,
		1, 1, 1, 1, 1, 1, 1, 1, 1, 1, 1,
		1, 1, 1, 1, 1, 1, 1, 1, 1, 1, 1,
		1, 1, 1, 1, 1, 1, 1, 1, 1, 1, 1,
		1, 1, 1, 1, 1, 1, 1, 1, 1, 1, 1,
		1, 1, 1, 1
	};
	palette[0] = {0, 0, 0};
	palette[1] = {32, 0, 0};
	this->set(heart, palette, true);
}

//---------------------------------------------------------------------------------------
// renderGreen
//
// Renders a complete green frame for testing purposes.
//
// -> --
// <- --
//---------------------------------------------------------------------------------------
void LEDFunctionsClass::renderGreen()
{
	palette_entry palette[2];
	uint8_t heart[] = {
		1, 1, 1, 1, 1, 1, 1, 1, 1, 1, 1,
		1, 1, 1, 1, 1, 1, 1, 1, 1, 1, 1,
		1, 1, 1, 1, 1, 1, 1, 1, 1, 1, 1,
		1, 1, 1, 1, 1, 1, 1, 1, 1, 1, 1,
		1, 1, 1, 1, 1, 1, 1, 1, 1, 1, 1,
		1, 1, 1, 1, 1, 1, 1, 1, 1, 1, 1,
		1, 1, 1, 1, 1, 1, 1, 1, 1, 1, 1,
		1, 1, 1, 1, 1, 1, 1, 1, 1, 1, 1,
		1, 1, 1, 1, 1, 1, 1, 1, 1, 1, 1,
		1, 1, 1, 1, 1, 1, 1, 1, 1, 1, 1,
		1, 1, 1, 1
	};
	palette[0] = {0, 0, 0};
	palette[1] = {0, 32, 0};
	this->set(heart, palette, true);
}

//---------------------------------------------------------------------------------------
// renderBlue
//
// Renders a complete blue frame for testing purposes.
//
// -> --
// <- --
//---------------------------------------------------------------------------------------
void LEDFunctionsClass::renderBlue()
{
	palette_entry palette[2];
	uint8_t heart[] = {
		1, 1, 1, 1, 1, 1, 1, 1, 1, 1, 1,
		1, 1, 1, 1, 1, 1, 1, 1, 1, 1, 1,
		1, 1, 1, 1, 1, 1, 1, 1, 1, 1, 1,
		1, 1, 1, 1, 1, 1, 1, 1, 1, 1, 1,
		1, 1, 1, 1, 1, 1, 1, 1, 1, 1, 1,
		1, 1, 1, 1, 1, 1, 1, 1, 1, 1, 1,
		1, 1, 1, 1, 1, 1, 1, 1, 1, 1, 1,
		1, 1, 1, 1, 1, 1, 1, 1, 1, 1, 1,
		1, 1, 1, 1, 1, 1, 1, 1, 1, 1, 1,
		1, 1, 1, 1, 1, 1, 1, 1, 1, 1, 1,
		1, 1, 1, 1
	};
	palette[0] = {0, 0, 0};
	palette[1] = {0, 0, 32};
	this->set(heart, palette, true);
}

//---------------------------------------------------------------------------------------
// renderUpdate
//
// Renders the OTA update screen with progress information depending on
// Config.updateProgress
//
// -> --
// <- --
//---------------------------------------------------------------------------------------
void LEDFunctionsClass::renderUpdate()
{
	uint8_t update[] = {
		0, 0, 0, 1, 1, 1, 1, 1, 0, 0, 0,
		0, 0, 0, 1, 0, 0, 0, 1, 0, 0, 0,
		0, 0, 0, 1, 0, 0, 0, 1, 0, 0, 0,
		0, 0, 0, 1, 0, 0, 0, 1, 0, 0, 0,
		0, 0, 0, 1, 0, 0, 0, 1, 0, 0, 0,
		0, 1, 1, 1, 0, 0, 0, 1, 1, 1, 0,
		0, 0, 1, 0, 0, 0, 0, 0, 1, 0, 0,
		0, 0, 0, 1, 0, 0, 0, 1, 0, 0, 0,
		0, 0, 0, 0, 1, 0, 1, 0, 0, 0, 0,
		0, 0, 0, 0, 0, 1, 0, 0, 0, 0, 0,
		1, 1, 1, 1
	};
	palette_entry p[] = {{0, 0, 0}, {255, 0, 0}, {42, 21, 0}, {255, 85, 0}};
	for(int i=0; i<110; i++)
	{
		if(i<Config.updateProgress)
		{
			if(update[i] == 0) update[i] = 2;
			else update[i] = 3;
		}
	}
	this->set(update, p, true);
}

//---------------------------------------------------------------------------------------
// renderUpdateComplete
//
// Renders the OTA update complete screen
//
// -> --
// <- --
//---------------------------------------------------------------------------------------
void LEDFunctionsClass::renderUpdateComplete()
{
	const uint8_t update_ok[] = {
		0, 0, 0, 0, 0, 0, 0, 0, 0, 0, 0,
		0, 0, 0, 0, 0, 0, 0, 0, 0, 0, 0,
		0, 0, 0, 0, 0, 0, 0, 0, 0, 0, 0,
		0, 0, 0, 0, 0, 0, 0, 0, 0, 1, 0,
		0, 0, 0, 0, 0, 0, 0, 0, 1, 0, 0,
		0, 0, 0, 0, 0, 0, 0, 1, 0, 0, 0,
		0, 0, 1, 0, 0, 0, 1, 0, 0, 0, 0,
		0, 0, 0, 1, 0, 1, 0, 0, 0, 0, 0,
		0, 0, 0, 0, 1, 0, 0, 0, 0, 0, 0,
		0, 0, 0, 0, 0, 0, 0, 0, 0, 0, 0,
		1, 1, 1, 1
	};
	palette_entry p[] = {{0, 21, 0}, {0, 255, 0}};
	this->set(update_ok, p, true);
}

//---------------------------------------------------------------------------------------
// renderUpdateError
//
// Renders the OTA update error screen
//
// -> --
// <- --
//---------------------------------------------------------------------------------------
void LEDFunctionsClass::renderUpdateError()
{
	const uint8_t update_err[] = {
		0, 0, 0, 0, 0, 0, 0, 0, 0, 0, 0,
		0, 0, 0, 0, 0, 0, 0, 0, 0, 0, 0,
		0, 0, 0, 0, 0, 0, 0, 0, 0, 0, 0,
		0, 0, 0, 1, 0, 0, 0, 1, 0, 0, 0,
		0, 0, 0, 0, 1, 0, 1, 0, 0, 0, 0,
		0, 0, 0, 0, 0, 1, 0, 0, 0, 0, 0,
		0, 0, 0, 0, 1, 0, 1, 0, 0, 0, 0,
		0, 0, 0, 1, 0, 0, 0, 1, 0, 0, 0,
		0, 0, 0, 0, 0, 0, 0, 0, 0, 0, 0,
		0, 0, 0, 0, 0, 0, 0, 0, 0, 0, 0,
		1, 1, 1, 1
	};
	palette_entry p[] = {{0, 0, 0}, {255, 0, 0}};
	this->set(update_err, p, true);
}

//---------------------------------------------------------------------------------------
// renderWifiManager
//
// Renders the WifiManager screen
//
// -> --
// <- --
//---------------------------------------------------------------------------------------
void LEDFunctionsClass::renderWifiManager()
{
	const uint8_t wifimanager[] = {
		0, 0, 0, 1, 1, 1, 1, 0, 0, 0, 0,
		0, 0, 1, 1, 0, 0, 1, 1, 0, 0, 0,
		0, 0, 1, 1, 0, 0, 1, 1, 0, 0, 0,
		0, 0, 0, 0, 0, 0, 1, 1, 0, 0, 0,
		0, 0, 0, 0, 0, 1, 1, 0, 0, 0, 0,
		0, 0, 0, 0, 1, 1, 0, 0, 0, 0, 0,
		0, 0, 0, 0, 1, 1, 0, 0, 0, 0, 0,
		0, 0, 0, 0, 0, 0, 0, 0, 0, 0, 0,
		0, 0, 0, 0, 1, 1, 0, 0, 0, 0, 0,
		0, 0, 0, 0, 1, 1, 0, 0, 0, 0, 0,
		1, 1, 1, 1
	};
	palette_entry p[] = {{0, 0, 0}, {255, 255, 0}};
	this->set(wifimanager, p, true);
}

#endif
