thoralt/esp8266wordclock/ledfunctions.h

// ESP8266 Wordclock
// Copyright (C) 2016 Thoralt Franz, https://github.com/thoralt
//
//  See ledfunctions.cpp for description.
//
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
// You should have received a copy of the GNU General Public License
// along with this program.  If not, see <http://www.gnu.org/licenses/>.
#ifndef _LEDFUNCTIONS_H_
#define _LEDFUNCTIONS_H_

#include <Adafruit_NeoPixel.h>
#include <stdint.h>
#include <vector>

#include "config.h"
#include "matrixobject.h"
#include "starobject.h"
#include "particle.h"

typedef struct _leds_template_t
{
	int param0, param1, param2;
	const std::vector<int> LEDs;
} leds_template_t;

typedef struct _xy_t
{
	int xTarget, yTarget, x, y, delay, speed, counter;
} xy_t;

#define NUM_MATRIX_OBJECTS 25
#define NUM_STARS 10
#define NUM_BRIGHTNESS_CURVES 2

class LEDFunctionsClass
{
public:
	LEDFunctionsClass();
	~LEDFunctionsClass();
	void begin(int pin);
	void process();
	void setTime(int h, int m, int s, int ms);
	void setBrightness(int brightness);
	void setMode(DisplayMode newMode);
	void show();

	static int getOffset(int x, int y);
	static const int width = 11;
	static const int height = 10;
	uint8_t currentValues[NUM_PIXELS * 3];

private:
	static const std::vector<leds_template_t> hoursTemplate;
	static const std::vector<leds_template_t> minutesTemplate;
	static const palette_entry firePalette[];
	static const palette_entry plasmaPalette[];

	DisplayMode mode = DisplayMode::plain;


	std::vector<Particle*> particles;
	std::vector<xy_t> arrivingLetters;
	std::vector<xy_t> leavingLetters;
	std::vector<MatrixObject> matrix;
	std::vector<StarObject> stars;
	uint8_t targetValues[NUM_PIXELS * 3];
	Adafruit_NeoPixel *pixels = NULL;
	int heartBrightness = 0;
	int heartState = 0;
	int brightness = 96;
	int h = 0;
	int m = 0;
	int s = 0;
	int ms = 0;
	int lastM = -1;
	int lastH = -1;

	void fillBackground(int seconds, int milliseconds, uint8_t *buf);
	void renderRed();
	void renderGreen();
	void renderBlue();
	void renderMatrix();
	void renderHeart();
	void renderFire();
	void renderPlasma();
	void renderStars();
	void renderUpdate();
	void renderUpdateComplete();
	void renderUpdateError();
	void renderHourglass(uint8_t animationStep, bool green);
	void renderWifiManager();
	void renderTime(uint8_t *target, int h, int m, int s, int ms);
	void renderFlyingLetters();
	void prepareFlyingLetters(uint8_t *source);
	void renderExplosion();
	void prepareExplosion(uint8_t *source);
	void fade();
	void set(const uint8_t *buf, palette_entry palette[]);
	void set(const uint8_t *buf, palette_entry palette[], bool immediately);
	void setBuffer(uint8_t *target, const uint8_t *source, palette_entry palette[]);

	// this mapping table maps the linear memory buffer structure used throughout the
	// project to the physical layout of the LEDs
	static const uint32_t PROGMEM mapping[NUM_PIXELS];

	static const uint32_t PROGMEM brightnessCurveSelect[NUM_PIXELS];
	static const uint32_t PROGMEM brightnessCurvesR[256*NUM_BRIGHTNESS_CURVES];
	static const uint32_t PROGMEM brightnessCurvesG[256*NUM_BRIGHTNESS_CURVES];
	static const uint32_t PROGMEM brightnessCurvesB[256*NUM_BRIGHTNESS_CURVES];;
};

extern LEDFunctionsClass LED;

#endif
