thoralt/esp8266wordclock/(commit log)

2016-04-17 Added configuration option for heartbeat LED
2016-04-18 use more efficient exponential moving average filter for ADC input
2016-05-02 bugfix in matrix screensaver code, added random speed
    [brightness.cpp, ledfunctions.cpp, ledfunctions.h, matrixobject.cpp, matrixobject.h, starobject.cpp]
2016-10-13 Fix: New stars could possibly appear outside of screen
    [starobject.cpp]
2016-10-13 Fix: Now respects mapping table for matrix effect
    [matrixobject.cpp]
2016-10-13 added brightness correction tables for R, G, B; completely reorganized the way rendering takes place; added display mode flyingLettersDown
    [ledfunctions.cpp, ledfunctions.h]
2016-10-18 added debug mode for single LED access
2016-10-28 changed brightness filter to float to fix rounding errors
    [brightness.cpp, brightness.h, esp8266wordclock.ino]
2017-08-16 Major changes
    - config: added delayed save feature
    - config: default display mode is now DisplayMode::explode
    - ledfunctions: implemented plasma and fire effect
